henrique-correia-it/solar-tracker/hardware/kicad/production/bom.csv

Designator | Footprint | Quantity | Value | LCSC Part #
C1, C2 | C_Disc_D5.0mm_W2.5mm_P2.50mm | 2 | 22pF
C3, C4 | C_Disc_D5.0mm_W2.5mm_P2.50mm | 2 | 100nF
D1 | LED_D5.0mm | 1 | Status
J1 | USB_A_Molex_67643_Horizontal | 1 | USB_A
J5 | IDC-Header_2x03_P2.54mm_Vertical | 1 | ISP
J6 | PinSocket_1x06_P2.54mm_Vertical | 1 | Servos
J7 | PinSocket_1x06_P2.54mm_Vertical | 1 | BT
J8 | PinSocket_1x05_P2.54mm_Vertical | 1 | LDRs
J9 | PinSocket_1x03_P2.54mm_Vertical | 1 | DHT
R1, R2, R5, R6, R7, R8 | R_Axial_DIN0207_L6.3mm_D2.5mm_P7.62mm_Horizontal | 6 | 10k
R3 | R_Axial_DIN0207_L6.3mm_D2.5mm_P7.62mm_Horizontal | 1 | 1k
R4 | R_Axial_DIN0207_L6.3mm_D2.5mm_P7.62mm_Horizontal | 1 | 2k
SW1 | SW_PUSH_6mm | 1 | Reset
U1 | DIP-28_W7.62mm | 1 | ATmega328P-P
Y1 | Crystal_HC49-U_Vertical | 1 | 16MHz
