henrique-correia-it/solar-tracker/hardware/3d-models/ARM.stl

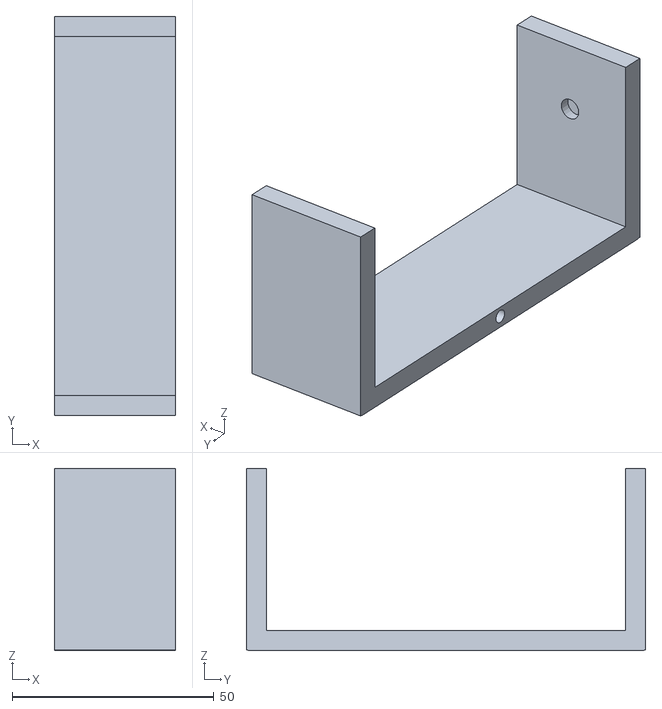
[picture p5: CAD file, 2026-11-11]
hardware/3d-models/ARM.stl
30.0 x 98.8 x 45.1
