henrique-correia-it/solar-tracker/hardware/3d-models/BOTTOM SECTION.stl

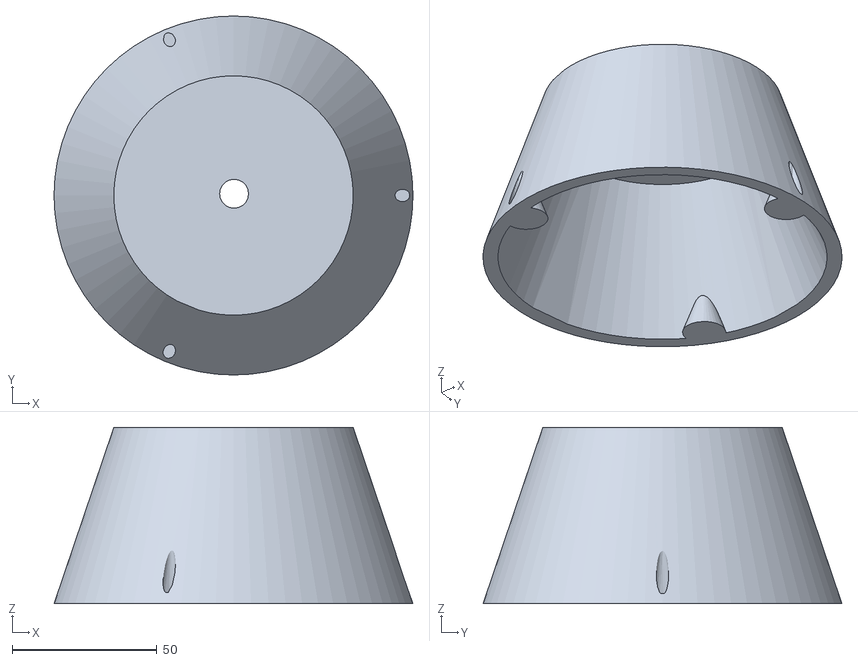
[picture p6: CAD file, 2026-11-11]
hardware/3d-models/BOTTOM SECTION.stl
124.1 x 124.1 x 61.0
