henrique-correia-it/solar-tracker/hardware/3d-models/BASE (Optional).stl

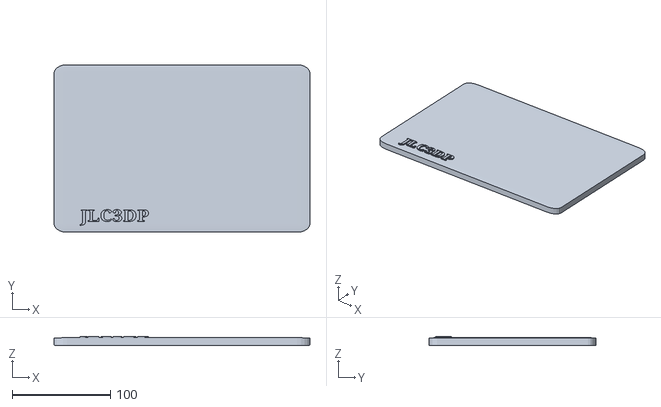
[picture p7: CAD file, 2026-11-11]
hardware/3d-models/BASE (Optional).stl
260.0 x 170.0 x 9.31
