henrique-correia-it/solar-tracker/hardware/3d-models/LDR MOUNT.stl

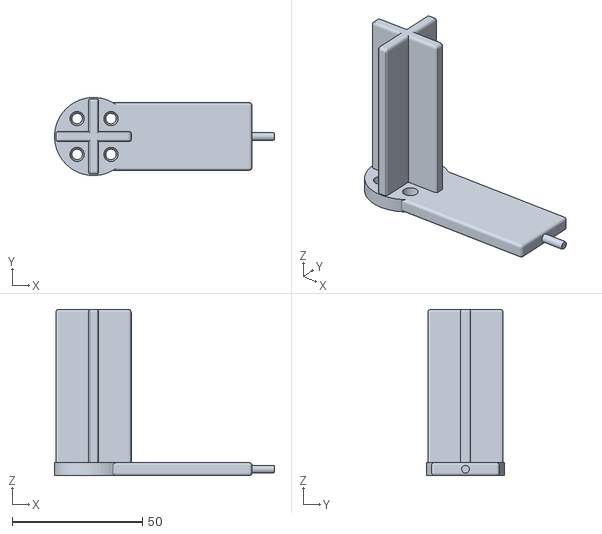
[picture p8: CAD file, 2026-11-11]
hardware/3d-models/LDR MOUNT.stl
84.6 x 30.0 x 63.9
