henrique-correia-it/solar-tracker/hardware/3d-models/MIDDLE SECTION.stl

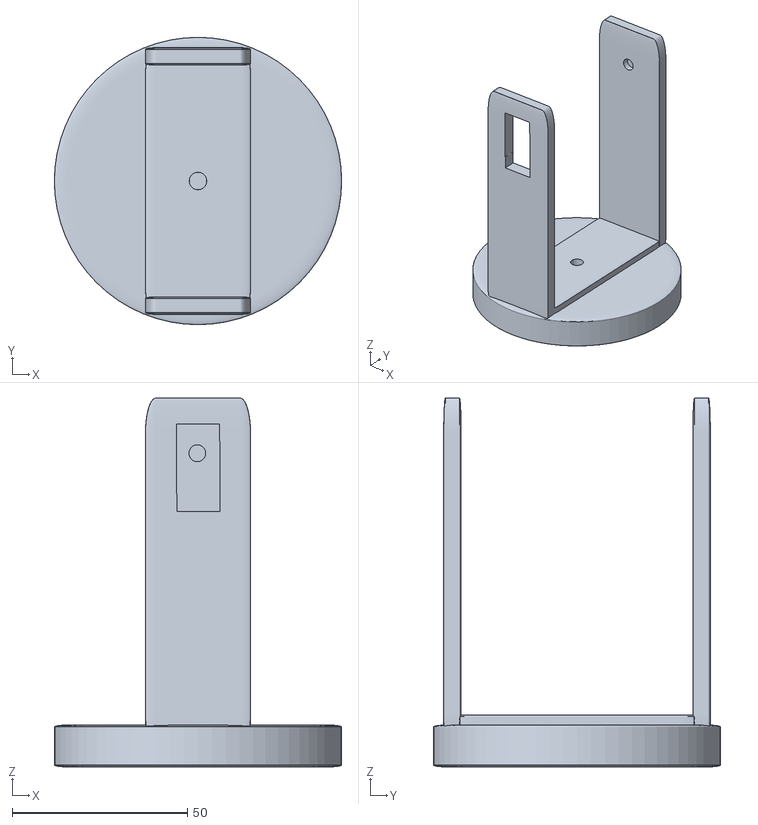
[picture p9: CAD file, 2026-11-11]
hardware/3d-models/MIDDLE SECTION.stl
82.0 x 82.0 x 105.3
