henrique-correia-it/solar-tracker/hardware/kicad/Placa_labsi.kicad_pcb

## KiCad design hardware/kicad/Placa_labsi.kicad_pcb (2026-11-11)

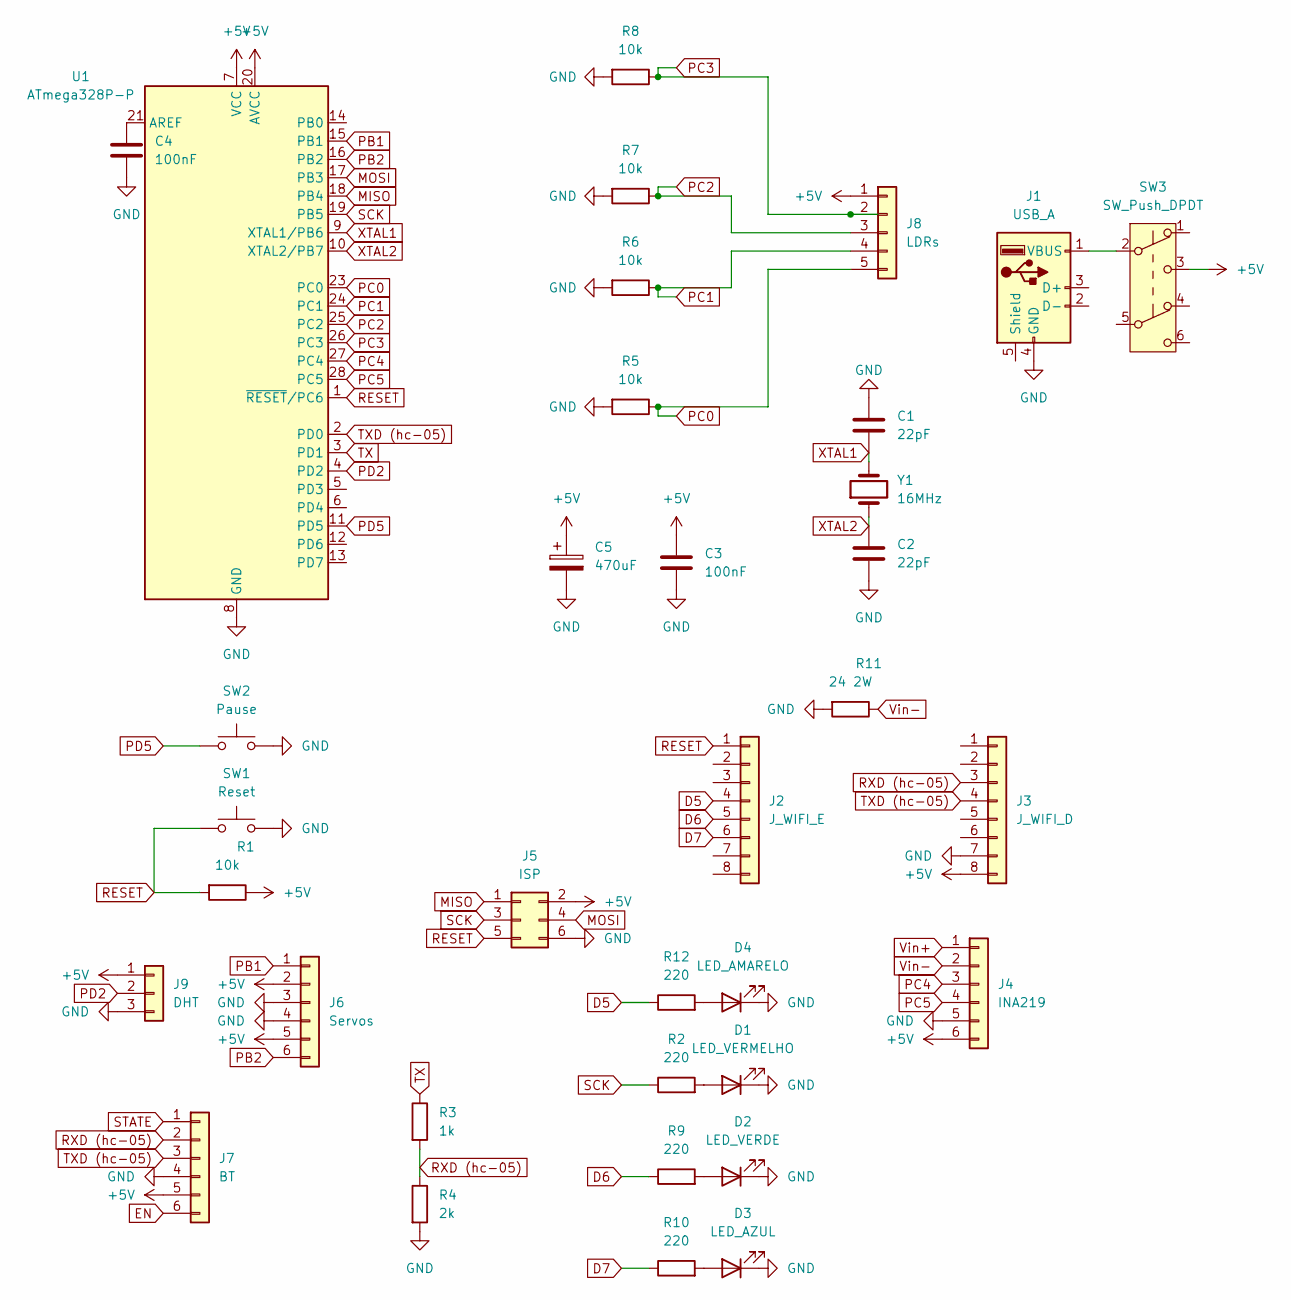
[picture p10: schematic Placa_labsi.kicad_sch]

Parts:
C1, C2: 22pF; C_Disc_D5.0mm_W2.5mm_P2.50mm
C3, C4: 100nF; C_Disc_D5.0mm_W2.5mm_P2.50mm
C5: 470uF; CP_Radial_D6.3mm_P2.50mm
D1: LED_VERMELHO; LED_D5.0mm
D2: LED_VERDE; LED_D5.0mm
D3: LED_AZUL; LED_D5.0mm
D4: LED_AMARELO; LED_D5.0mm
J1: USB_A; USB_A_Molex_67643_Horizontal
J2: J_WIFI_E; PinSocket_1x08_P2.54mm_Vertical
J3: J_WIFI_D; PinSocket_1x08_P2.54mm_Vertical
J4: INA219; PinSocket_1x06_P2.54mm_Vertical
J5: ISP; IDC-Header_2x03_P2.54mm_Vertical
J6: Servos; PinSocket_1x06_P2.54mm_Vertical
J7: BT; PinSocket_1x06_P2.54mm_Vertical
J8: LDRs; PinSocket_1x05_P2.54mm_Vertical
J9: DHT; PinSocket_1x03_P2.54mm_Vertical
R1, R5, R6, R7, R8: 10k; R_Axial_DIN0207_L6.3mm_D2.5mm_P7.62mm_Horizontal
R2, R9, R10, R12: 220; R_Axial_DIN0207_L6.3mm_D2.5mm_P7.62mm_Horizontal
R3: 1k; R_Axial_DIN0207_L6.3mm_D2.5mm_P7.62mm_Horizontal
R4: 2k; R_Axial_DIN0207_L6.3mm_D2.5mm_P7.62mm_Horizontal
R11: 24 2W; R_Axial_DIN0414_L11.9mm_D4.5mm_P15.24mm_Horizontal
SW1: Reset; SW_PUSH_6mm
SW2: Pause; SW_PUSH_6mm
SW3: SW_Push_DPDT; SW_CK_JS202011CQN_DPDT_Straight
U1: ATmega328P-P; DIP-28_W7.62mm_Socket
Y1: 16MHz; Crystal_HC49-U_Vertical

Connections:
+5V: C3.1, C5.1, J3.8, J4.6, J5.2, J6.2, J6.5, J7.5, J8.1, J9.1, R1.1, SW3.3 (C), U1.7 (VCC), U1.20 (AVCC)
D5: J2.4, R12.1
D6: J2.5, R9.1
D7: J2.6, R10.1
EN: J7.6
GND: C1.1, C2.2, C3.2, C4.2, C5.2, D1.1 (K), D2.1 (K), D3.1 (K), D4.1 (K), J1.4 (GND), J3.7, J4.5, J5.6, J6.3, J6.4, J7.4, J9.3, R4.2, R5.2, R6.2, R7.2, R8.2, R11.2, SW1.2, SW2.2, U1.8 (GND), U1.22 (GND)
MISO: J5.1, U1.18 (PB4)
MOSI: J5.4, U1.17 (PB3)
unnamed: D1.2 (A), R2.2
unnamed: D2.2 (A), R9.2
unnamed: D3.2 (A), R10.2
unnamed: D4.2 (A), R12.2
unnamed: J1.1 (VBUS), SW3.2 (B)
unnamed: C4.1, U1.21 (AREF)
PB1: J6.1, U1.15 (PB1)
PB2: J6.6, U1.16 (PB2)
PC0: J8.5, R5.1, U1.23 (PC0)
PC1: J8.4, R6.1, U1.24 (PC1)
PC2: J8.3, R7.1, U1.25 (PC2)
PC3: J8.2, R8.1, U1.26 (PC3)
PC4: J4.3, U1.27 (PC4)
PC5: J4.4, U1.28 (PC5)
PD2: J9.2, U1.4 (PD2)
PD5: SW2.1, U1.11 (PD5)
RESET: J2.1, J5.5, R1.2, SW1.1, U1.1 (~RESET/PC6)
RXD (hc-05): J3.3, J7.2, R3.2, R4.1
SCK: J5.3, R2.1, U1.19 (PB5)
STATE: J7.1
TX: R3.1, U1.3 (PD1)
TXD (hc-05): J3.4, J7.3, U1.2 (PD0)
Vin+: J4.1
Vin-: J4.2, R11.1
XTAL1: C1.2, U1.9 (XTAL1/PB6), Y1.2
XTAL2: C2.1, U1.10 (XTAL2/PB7), Y1.1

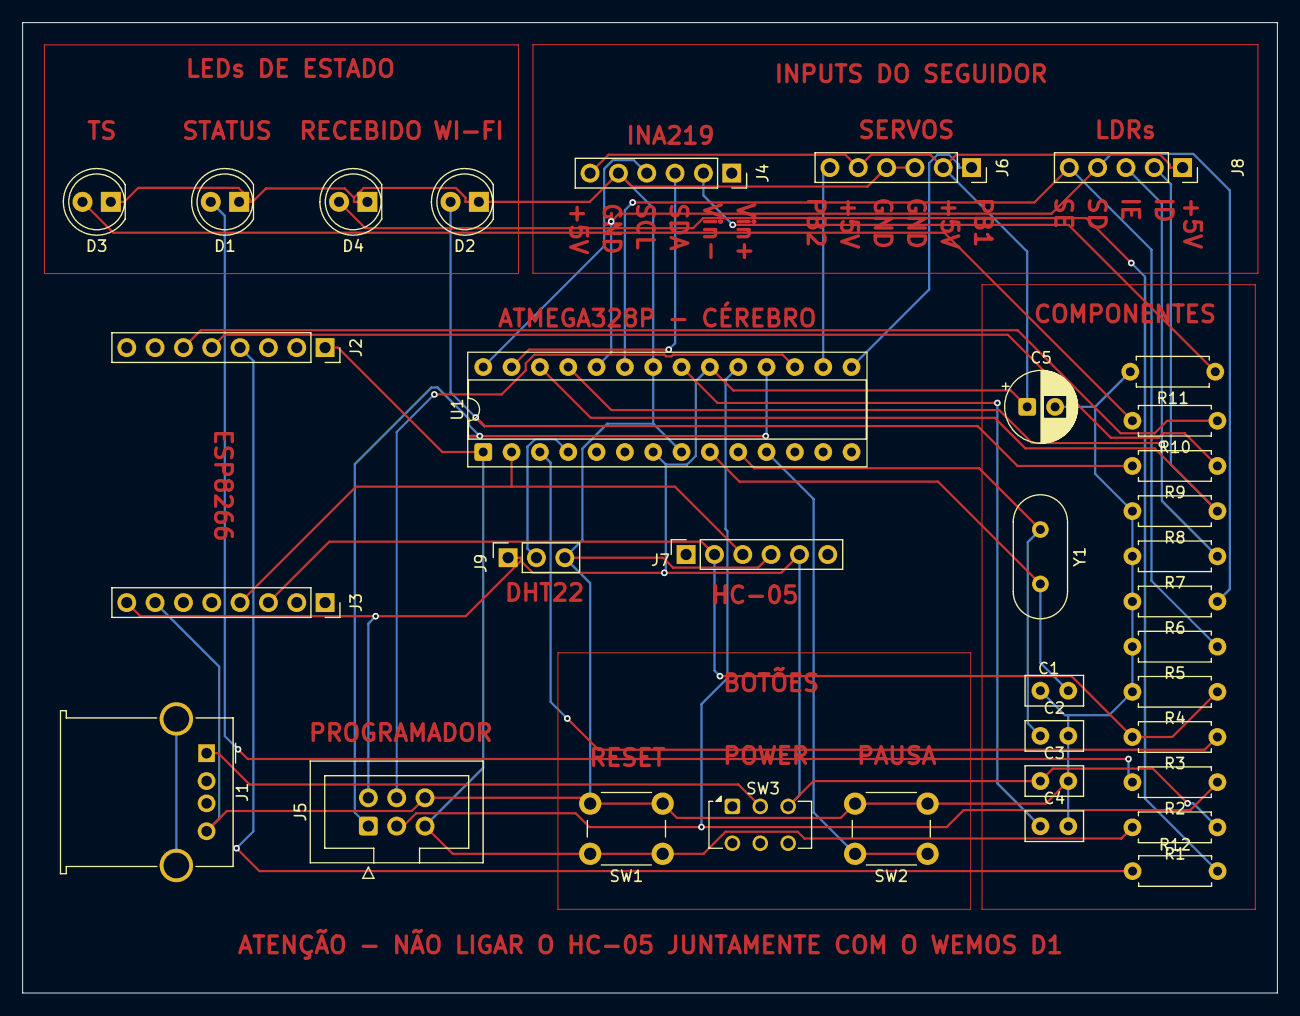
[picture p11: board Placa_labsi.kicad_pcb from above]

Board: 2 copper layers, 112.5 x 87.0 mm, 35 parts (0 on the bottom side), 31 nets.
