henrique-correia-it/solar-tracker/firmware/esp8266/secrets.example.h

#pragma once
// Copy this file to secrets.h (ignored by Git) and fill in your own values.
#define WIFI_SSID "your-wifi-ssid"
#define WIFI_PASSWORD "your-wifi-password"
#define THINGSPEAK_WRITE_KEY "your-thingspeak-write-key"
